doitnowlabs/rpieffectbox/Rpieffectbox.png

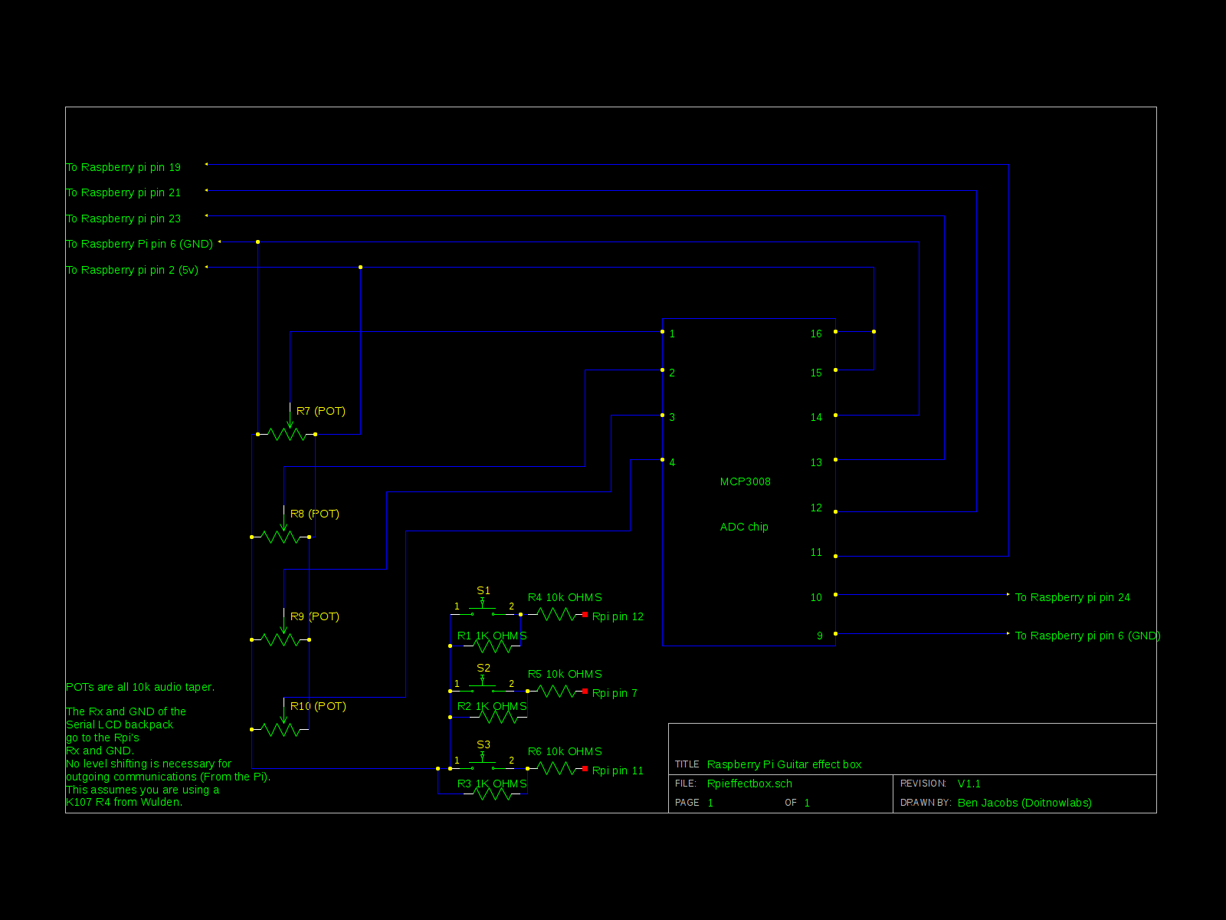
Rpieffectbox.png
