doitnowlabs/rpieffectbox/Soundcard.png

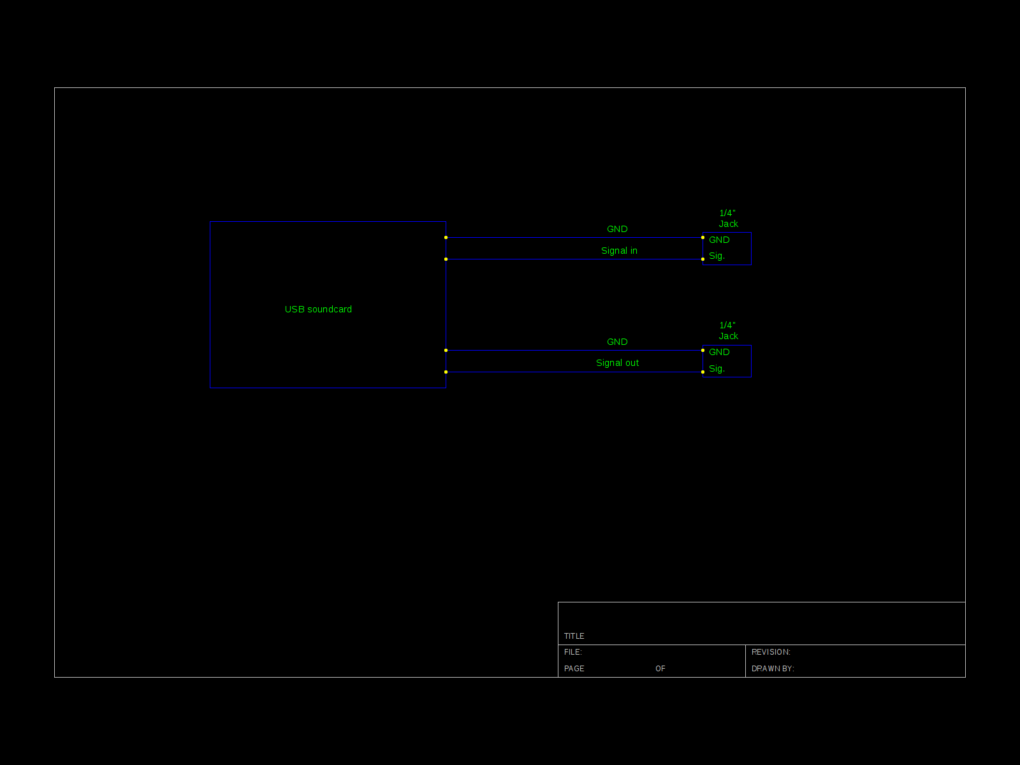
Soundcard.png
