doitnowlabs/rpieffectbox/(commit log)

2013-05-07 Update Instructions.txt
    Explained why SPI is needed on lines 41 and 42.
2013-07-24 Update Rpieffectbox.sch
    Changed R1, 2, and 3 from .2 ohms to 1k ohms, as they should be.
    Sorry for any inconvenience.
    [Rpieffectbox.sch]
2014-04-02 Added warning at bottom and added BOM
    Added a parts list, due to many emails asking for one.
2015-02-20 Added PNG Schematics
    If anyone still has interest in this project, I’ve added some easy to
    open PNG images of the schematic, because there is no mac or windows
    version of GEDA.
